hertzmanlucas/Drone/esp32_quad_frame_v1/preview_parts.png

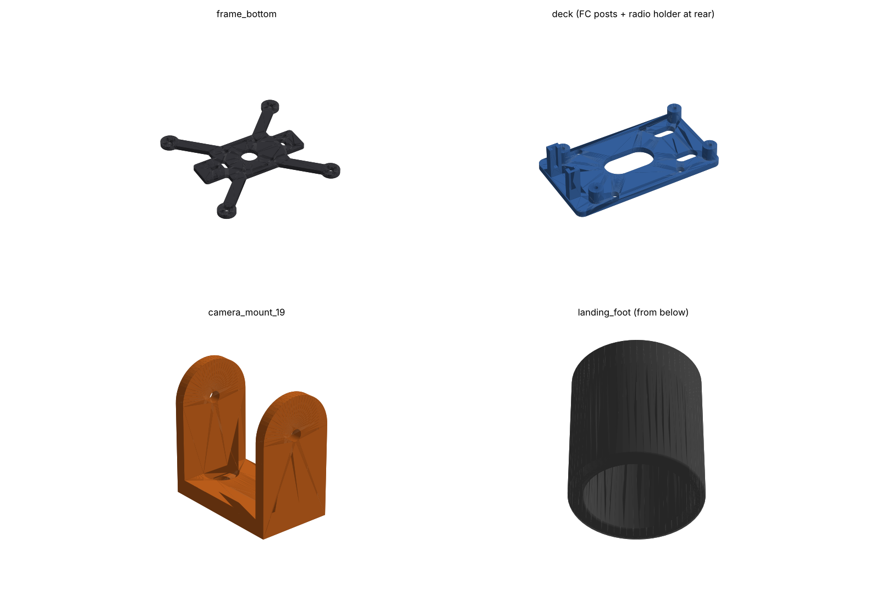
esp32_quad_frame_v1/preview_parts.png
