hertzmanlucas/Drone/esp32_quad_frame_v1/drone_assembly.step

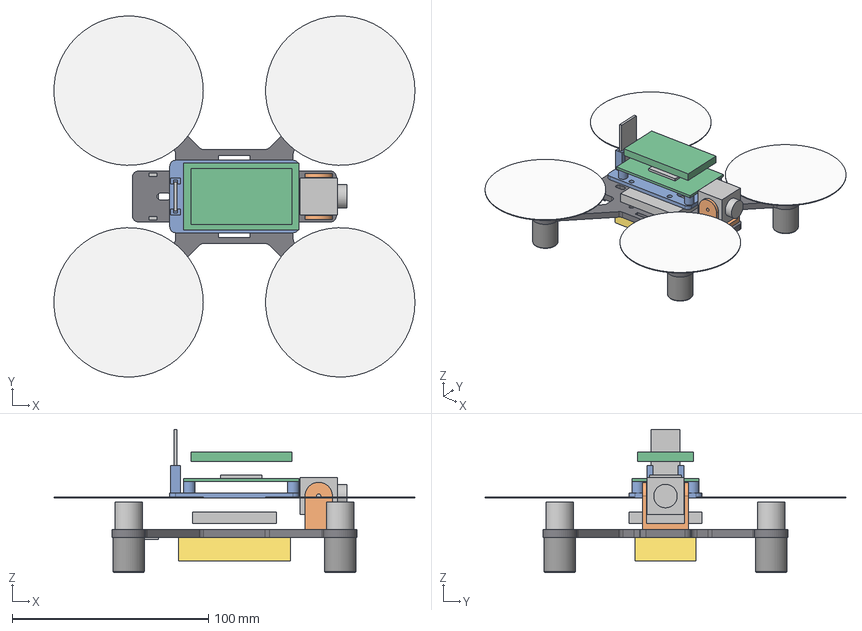
[picture p2: CAD file, 2026-11-05]
esp32_quad_frame_v1/drone_assembly.step
184.1 x 184.2 x 73.0 mm
frame_bottom
deck
camera_mount_19
ESC_4in1_dummy
FC_perfboard_dummy
MPU6050_dummy
ESP32_DevKit_dummy
Radio_dummy
Battery_2S_650_dummy
VL53L0X_dummy
Camera_19mm_dummy
Motor_1_dummy
Prop_disc_1
Foot_1
Motor_2_dummy
Prop_disc_2
Foot_2
Motor_3_dummy
Prop_disc_3
Foot_3
Motor_4_dummy
Prop_disc_4
Foot_4
