hertzmanlucas/Drone/esp32_quad_frame_v1/camera_mount_19.step

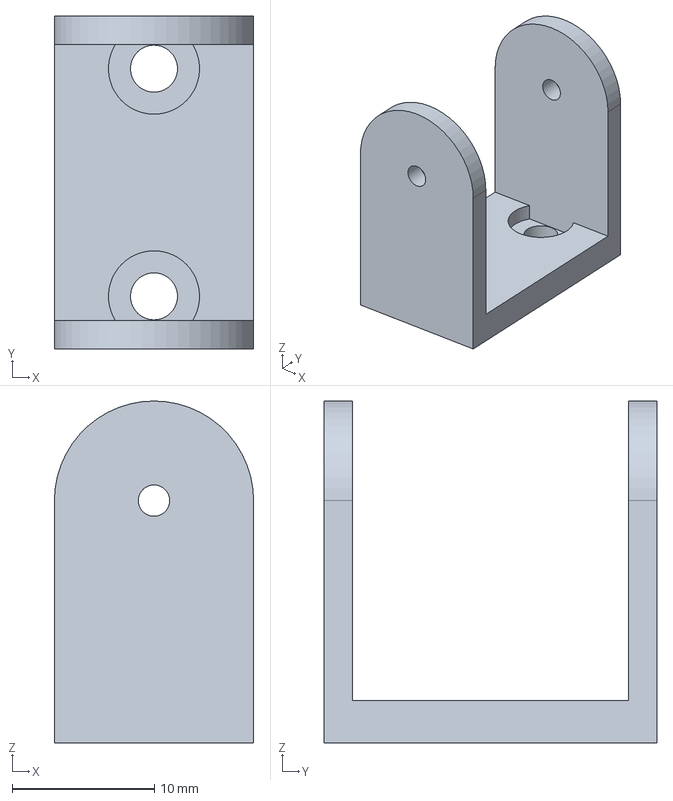
[picture p3: CAD file, 2026-11-05]
esp32_quad_frame_v1/camera_mount_19.step
14.0 x 23.4 x 24.0 mm
