hertzmanlucas/Drone/frame_bottom.3mf

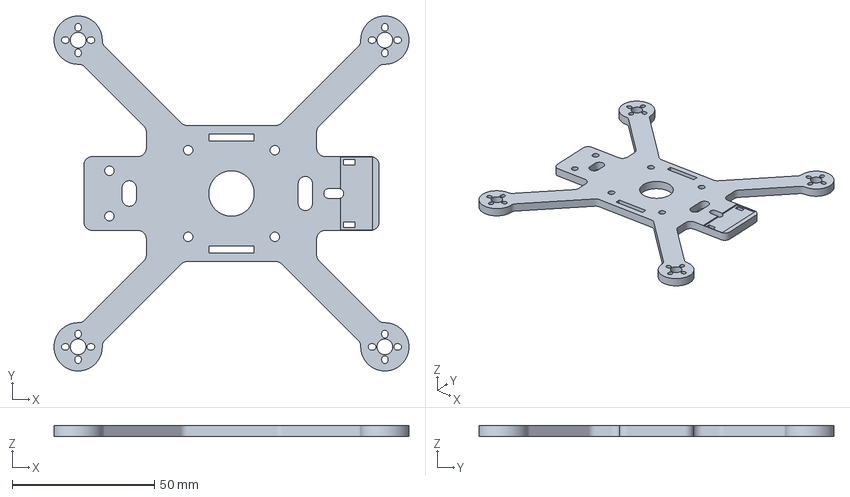
[picture p4: CAD file, 2026-11-05]
frame_bottom.3mf
125.0 x 125.0 x 4.00 mm
