hertzmanlucas/Drone/esp32_quad_frame_v1/camera_mount_14.step

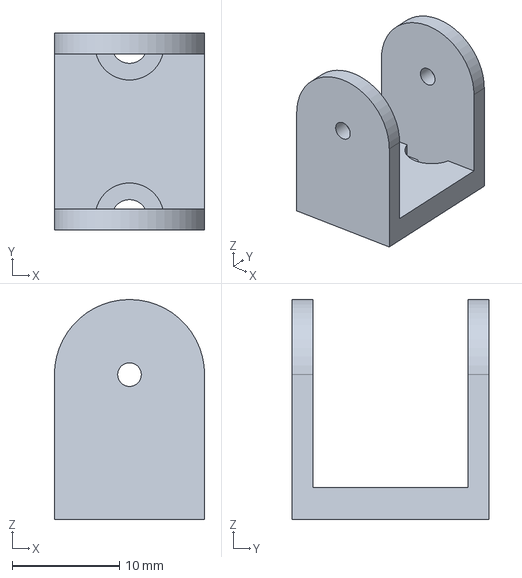
[picture p5: CAD file, 2026-11-05]
esp32_quad_frame_v1/camera_mount_14.step
14.0 x 18.4 x 20.5 mm
