hertzmanlucas/Drone/esp32_quad_frame_v1/deck.step

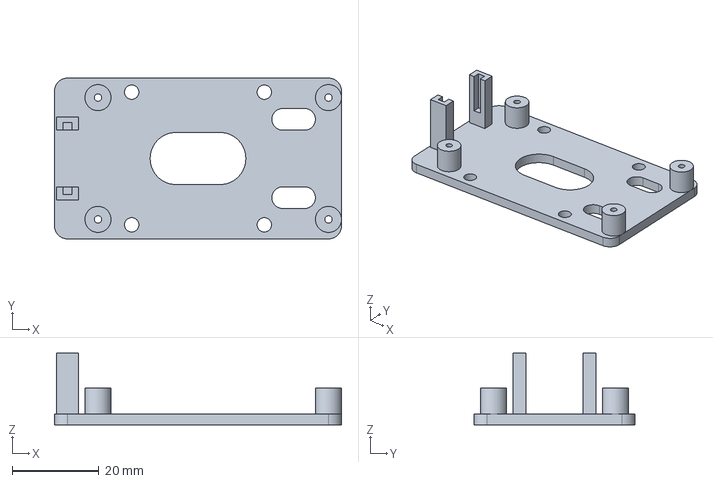
[picture p6: CAD file, 2026-11-05]
esp32_quad_frame_v1/deck.step
66.0 x 37.0 x 16.5 mm
