hertzmanlucas/Drone/esp32_quad_frame_v1/landing_foot.step

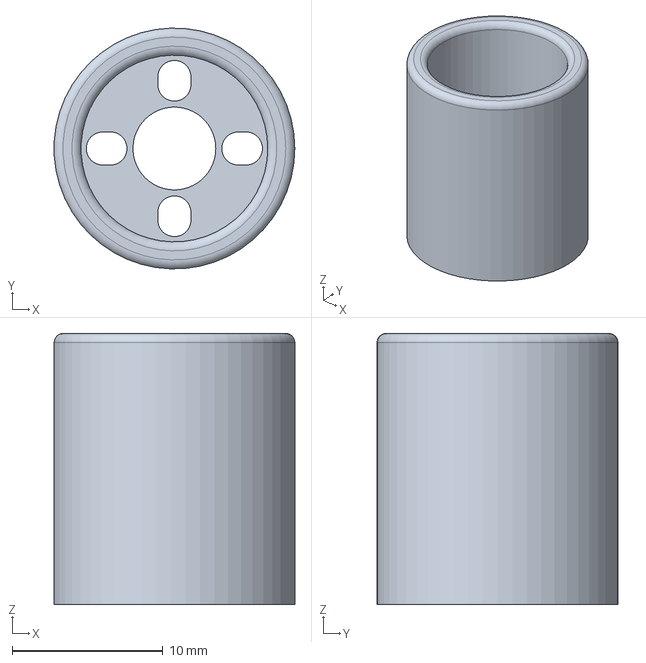
[picture p7: CAD file, 2026-11-05]
esp32_quad_frame_v1/landing_foot.step
16.0 x 16.0 x 18.0 mm
