hertzmanlucas/Drone/(list of files, cad)

Other CAD files:
esp32_quad_frame_v1/frame_bottom.step
esp32_quad_frame_v1/camera_mount_14.stl
esp32_quad_frame_v1/camera_mount_19.stl
esp32_quad_frame_v1/deck.stl
esp32_quad_frame_v1/frame_bottom.stl
esp32_quad_frame_v1/landing_foot.stl
