hertzmanlucas/Drone/(commit log)

2026-09-01 Legg til Arduino-sketch for MPU6050-avlesning
2026-11-05 Legg til Arduino-sketch for joystick-test
2026-11-05 Legg til motortest, radiotest og bunnramme, forbedre gyrotest
    - motorTest: styr én motor på BLHeli-ESC med potmeter via ESP32
    - radioSender/radioReceiver: send potmeterverdi over nRF24L01 og styr motor
    - gyrotest: bias-kalibrering, glatting, sikrere I2C-lesing og 115200 baud
    - Flytt accelerometer.ino til accelerometerTest/
    - Legg til frame_bottom.3mf (3D-modell av bunnrammen)
    [frame_bottom.3mf]
2026-11-05 Frame and code for joystick
    [camera_mount_14.step, camera_mount_14.stl, camera_mount_19.step, camera_mount_19.stl, deck.step, deck.stl, drone_assembly.step, frame_bottom.step]
2026-11-05 Legg til motortest styrt med joystick over radio
    Mottaker for dronen som tar imot pakkene fra joystickSender og styrer
    de fire motorene på ESC-en. Spaken fram gir gass, knappen bytter
    mellom M1-M4 og alle. Låst til spaken står i midten, stopper ved
    signaltap, og maks gass er satt til 50 % mens vi tester.
2026-11-05 Legg til ESC-kalibrering for alle fire motorene
    M1 startet på lavere gass enn M2-M4 fordi hver ESC-brikke husker sitt
    eget gassområde. escKalibrering gir alle fire samme område (1000-2000
    µs) via Serial Monitor: k sender full gass før batteriet kobles til,
    n sender nullgass. Full gass kan ikke sendes igjen uten reset.
    Motortesten viser nå til kalibreringen hvis motorene starter ulikt.
    [escKalibrering.ino, motor_test_joystick_radio.ino]
